MicheleMassa802/computer-controlled-signal-randomized-translingual-neurostimulator/PoNS/PoNS.kicad_pcb

## KiCad design PoNS/PoNS.kicad_pcb (2026-05-09)

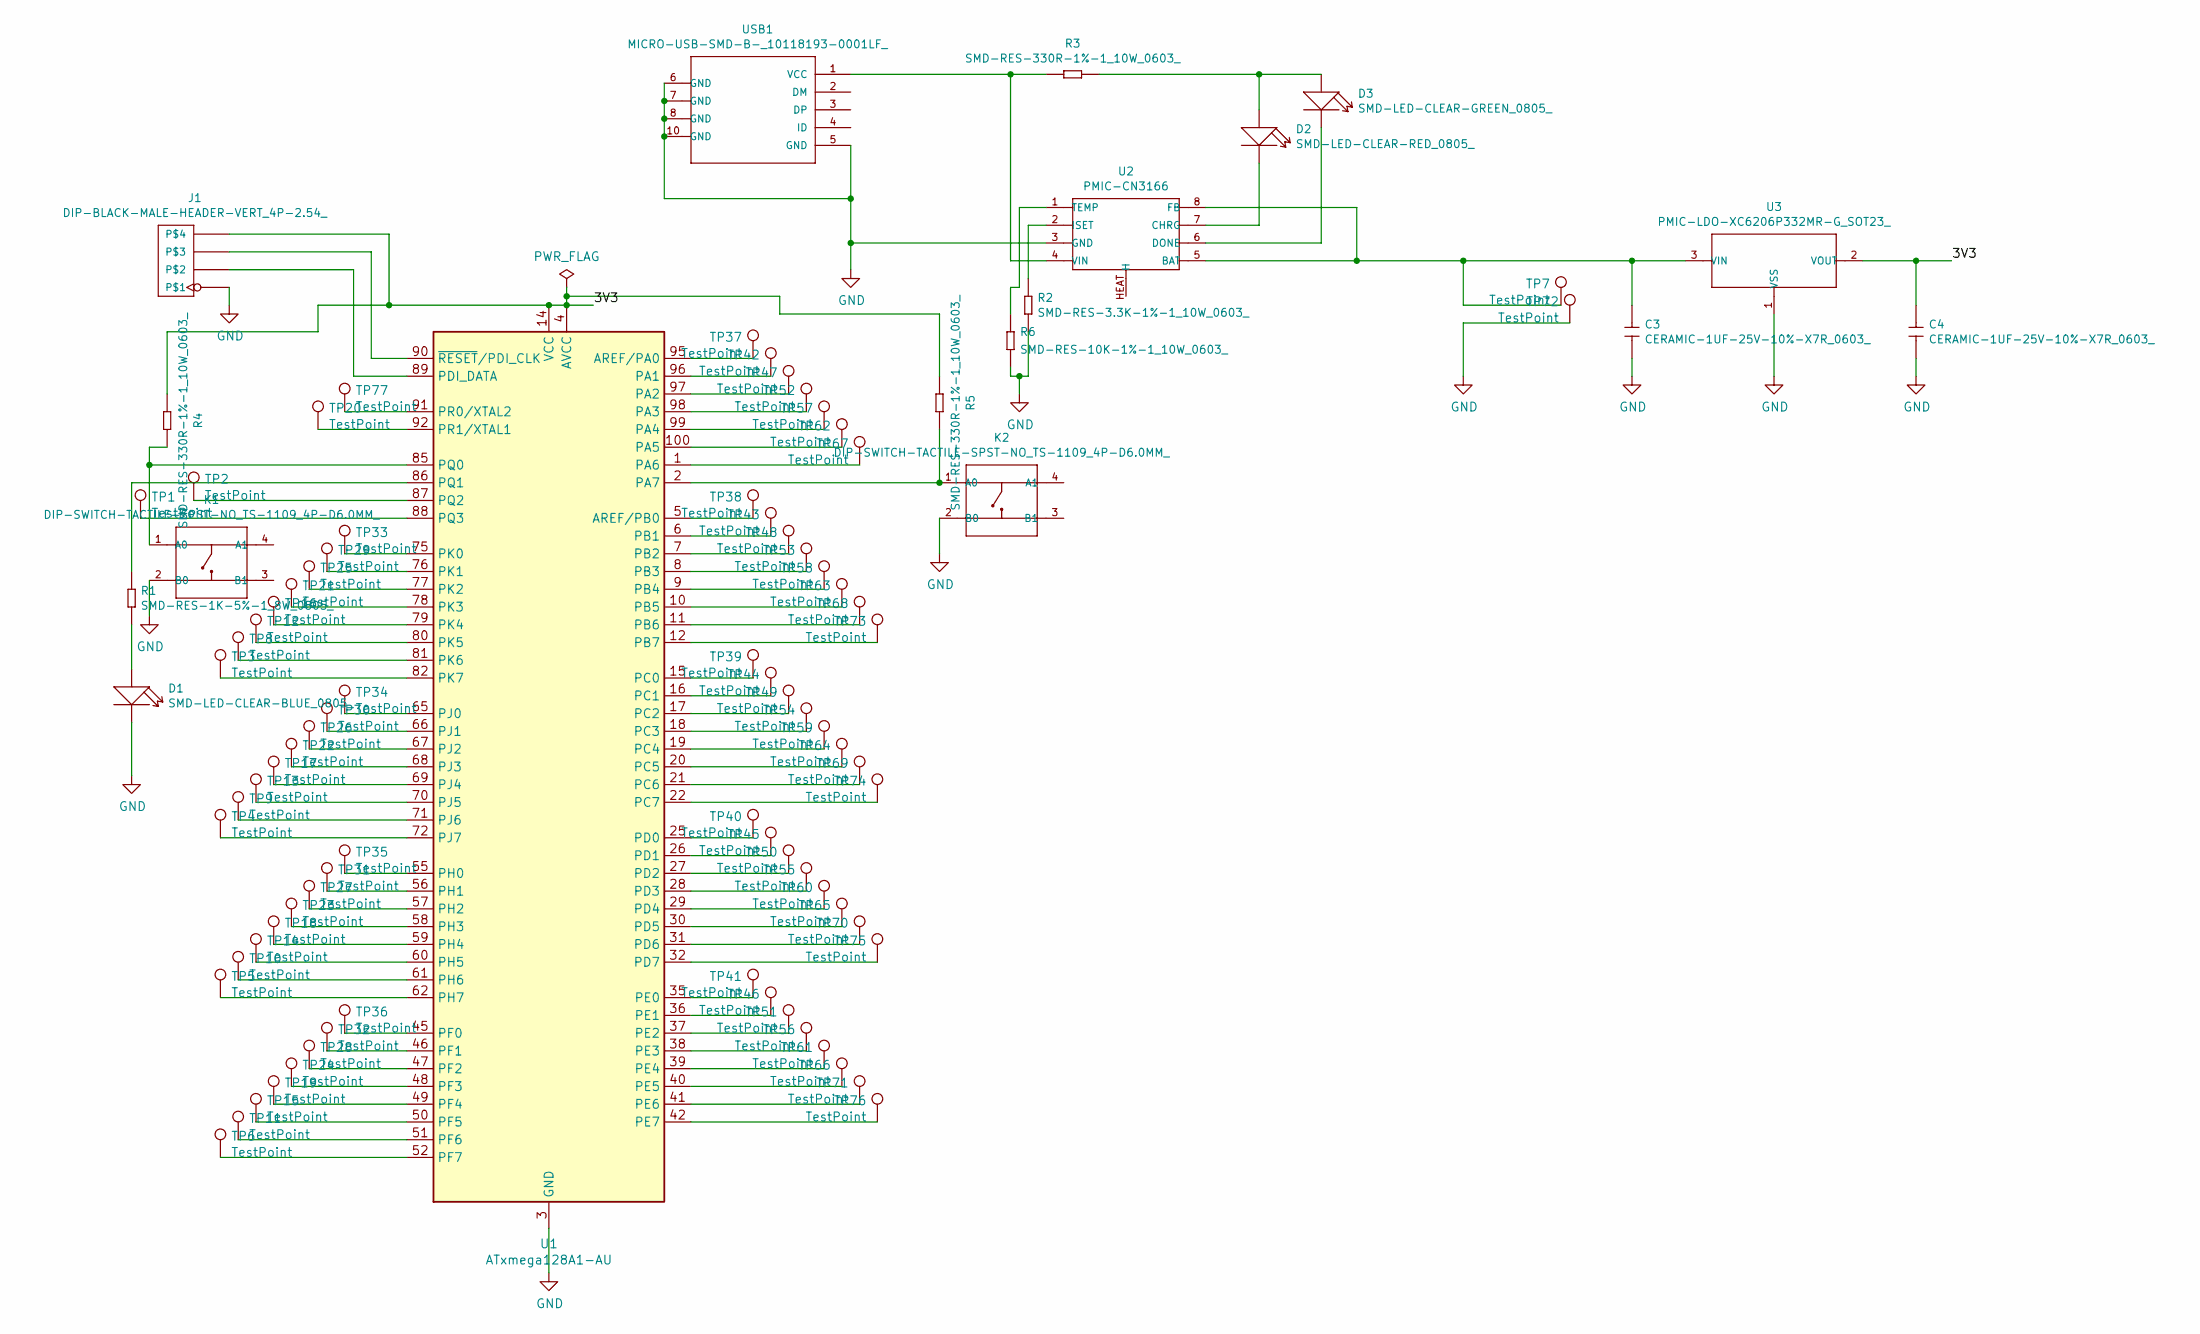
[picture p4: schematic PoNS.kicad_sch]

Parts:
C3, C4: CERAMIC-1UF-25V-10%-X7R_0603_; C0603; MPN CC0603KRX7R8BB105
D1: SMD-LED-CLEAR-BLUE_0805_; LED-0805; MPN EL-17-215_BHC-AN1P2_3T
D2: SMD-LED-CLEAR-RED_0805_; LED-0805; MPN 17-215SURC_S530-A2_TR8
D3: SMD-LED-CLEAR-GREEN_0805_; LED-0805; MPN 17-215SYGC_S530-E2_TR8
J1: DIP-BLACK-MALE-HEADER-VERT_4P-2.54_; H4-2.54; MPN P125-1104A0BS116A1
K1, K2: DIP-SWITCH-TACTILE-SPST-NO_TS-1109_4P-D6.0MM_; SW4-6.0X6.0X5.0MM
R1: SMD-RES-1K-5%-1_8W_0805_; R0805; MPN RC0805JR-071KL
R2: SMD-RES-3.3K-1%-1_10W_0603_; R0603; MPN RC0603FR-073K3L
R3, R4, R5: SMD-RES-330R-1%-1_10W_0603_; R0603; MPN RC0603FR-07330RL
R6: SMD-RES-10K-1%-1_10W_0603_; R0603; MPN RC0603FR-0710KL
TP1, TP2, TP3, TP4, TP5, TP6, TP8, TP9, TP10, TP11, TP12, TP13, TP14, TP15, TP16, TP17, TP18, TP19, TP20, TP21, TP22, TP23, TP24, TP25, TP26, TP27, TP28, TP29, TP30, TP31, TP32, TP33, TP34, TP35, TP36, TP37, TP38, TP39, TP40, TP41, TP42, TP43, TP44, TP45, TP46, TP47, TP48, TP49, TP50, TP51, TP52, TP53, TP54, TP55, TP56, TP57, TP58, TP59, TP60, TP61, TP62, TP63, TP64, TP65, TP66, TP67, TP68, TP69, TP70, TP71, TP73, TP74, TP75, TP76, TP77: TestPoint; TestPoint_Pad_1.0x1.0mm
TP7, TP72: TestPoint; SolderWire-0.75sqmm_1x01_D1.25mm_OD2.3mm
U1: ATxmega128A1-AU; TQFP-100_14x14mm_P0.5mm
U2: PMIC-CN3166; DFN8G-0.5-3X3MM; MPN CN3065
U3: PMIC-LDO-XC6206P332MR-G_SOT23_; SOT-23; MPN XC6206P332MR-G
USB1: MICRO-USB-SMD-B-_10118193-0001LF_; MICRO-USB5+6P-SMD-0.65-B; MPN 10118193-0001LF

Connections:
/3V3: C4.1, J1.4, R4.1, R5.1, U1.4 (AVCC), U1.14 (VCC), U1.24 (VCC), U1.34 (VCC), U1.44 (VCC), U1.54 (VCC), U1.64 (VCC), U1.74 (VCC), U1.83 (VCC), U1.94 (AVCC), U3.2 (VOUT)
GND: C3.2, C4.2, D1.2 (-), J1.1, K1.2 (B0), K2.2 (B0), R2.2, R6.2, TP72.1, U1.3 (GND), U1.13 (GND), U1.23 (GND), U1.33 (GND), U1.43 (GND), U1.53 (GND), U1.63 (GND), U1.73 (GND), U1.84 (GND), U1.93 (GND), U2.3 (GND), U3.1 (VSS), USB1.5 (GND), USB1.6 (GND), USB1.7 (GND), USB1.8 (GND), USB1.9 (GND), USB1.10 (GND), USB1.11 (GND)
unnamed: D1.1 (+), R1.2
unnamed: D2.1 (+), D3.1 (+), R3.2
unnamed: D2.2 (-), U2.7 (CHRG)
unnamed: D3.2 (-), U2.6 (DONE)
unnamed: J1.2, U1.89 (PDI_DATA)
unnamed: J1.3, U1.90 (~RESET/PDI_CLK)
unnamed: K1.1 (A0), R4.2, U1.85 (PQ0)
unnamed: K2.1 (A0), R5.2, U1.2 (PA7)
unnamed: TP37.1, U1.95 (AREF/PA0)
unnamed: TP38.1, U1.5 (AREF/PB0)
unnamed: TP42.1, U1.96 (PA1)
unnamed: TP47.1, U1.97 (PA2)
unnamed: TP52.1, U1.98 (PA3)
unnamed: TP57.1, U1.99 (PA4)
unnamed: TP62.1, U1.100 (PA5)
unnamed: TP67.1, U1.1 (PA6)
unnamed: TP43.1, U1.6 (PB1)
unnamed: TP48.1, U1.7 (PB2)
unnamed: TP53.1, U1.8 (PB3)
unnamed: TP58.1, U1.9 (PB4)
unnamed: TP63.1, U1.10 (PB5)
unnamed: TP68.1, U1.11 (PB6)
unnamed: TP73.1, U1.12 (PB7)
unnamed: TP39.1, U1.15 (PC0)
unnamed: TP44.1, U1.16 (PC1)
unnamed: TP49.1, U1.17 (PC2)
unnamed: TP54.1, U1.18 (PC3)
unnamed: TP59.1, U1.19 (PC4)
unnamed: TP64.1, U1.20 (PC5)
unnamed: TP69.1, U1.21 (PC6)
unnamed: TP74.1, U1.22 (PC7)
unnamed: TP40.1, U1.25 (PD0)
unnamed: TP45.1, U1.26 (PD1)
unnamed: TP50.1, U1.27 (PD2)
unnamed: TP55.1, U1.28 (PD3)
unnamed: TP60.1, U1.29 (PD4)
unnamed: TP65.1, U1.30 (PD5)
unnamed: TP70.1, U1.31 (PD6)
unnamed: TP75.1, U1.32 (PD7)
unnamed: TP41.1, U1.35 (PE0)
unnamed: TP46.1, U1.36 (PE1)
unnamed: TP51.1, U1.37 (PE2)
unnamed: TP56.1, U1.38 (PE3)
unnamed: TP61.1, U1.39 (PE4)
unnamed: TP66.1, U1.40 (PE5)
unnamed: TP71.1, U1.41 (PE6)
unnamed: TP76.1, U1.42 (PE7)
unnamed: TP36.1, U1.45 (PF0)
unnamed: TP32.1, U1.46 (PF1)
unnamed: TP28.1, U1.47 (PF2)
unnamed: TP24.1, U1.48 (PF3)
unnamed: TP19.1, U1.49 (PF4)
unnamed: TP15.1, U1.50 (PF5)
unnamed: TP11.1, U1.51 (PF6)
unnamed: TP6.1, U1.52 (PF7)
unnamed: TP35.1, U1.55 (PH0)
unnamed: TP31.1, U1.56 (PH1)
unnamed: TP27.1, U1.57 (PH2)
unnamed: TP23.1, U1.58 (PH3)
unnamed: TP18.1, U1.59 (PH4)
unnamed: TP14.1, U1.60 (PH5)
unnamed: TP10.1, U1.61 (PH6)
unnamed: TP5.1, U1.62 (PH7)
unnamed: TP34.1, U1.65 (PJ0)
unnamed: TP30.1, U1.66 (PJ1)
unnamed: TP26.1, U1.67 (PJ2)
unnamed: TP22.1, U1.68 (PJ3)
unnamed: TP17.1, U1.69 (PJ4)
unnamed: TP13.1, U1.70 (PJ5)
unnamed: TP9.1, U1.71 (PJ6)
unnamed: TP4.1, U1.72 (PJ7)
unnamed: TP33.1, U1.75 (PK0)
unnamed: TP29.1, U1.76 (PK1)
unnamed: TP25.1, U1.77 (PK2)
unnamed: TP21.1, U1.78 (PK3)
unnamed: TP16.1, U1.79 (PK4)
unnamed: TP12.1, U1.80 (PK5)
unnamed: TP8.1, U1.81 (PK6)
unnamed: TP3.1, U1.82 (PK7)
unnamed: R1.1, U1.86 (PQ1)
unnamed: TP2.1, U1.87 (PQ2)
unnamed: TP1.1, U1.88 (PQ3)
unnamed: TP77.1, U1.91 (PR0/XTAL2)
unnamed: TP20.1, U1.92 (PR1/XTAL1)
unnamed: C3.1, TP7.1, U2.5 (BAT), U2.8 (FB), U3.3 (VIN)
unnamed: R2.1, U2.2 (ISET)
unnamed: R6.1, U2.1 (TEMP)
unnamed: R3.1, U2.4 (VIN), USB1.1 (VCC)

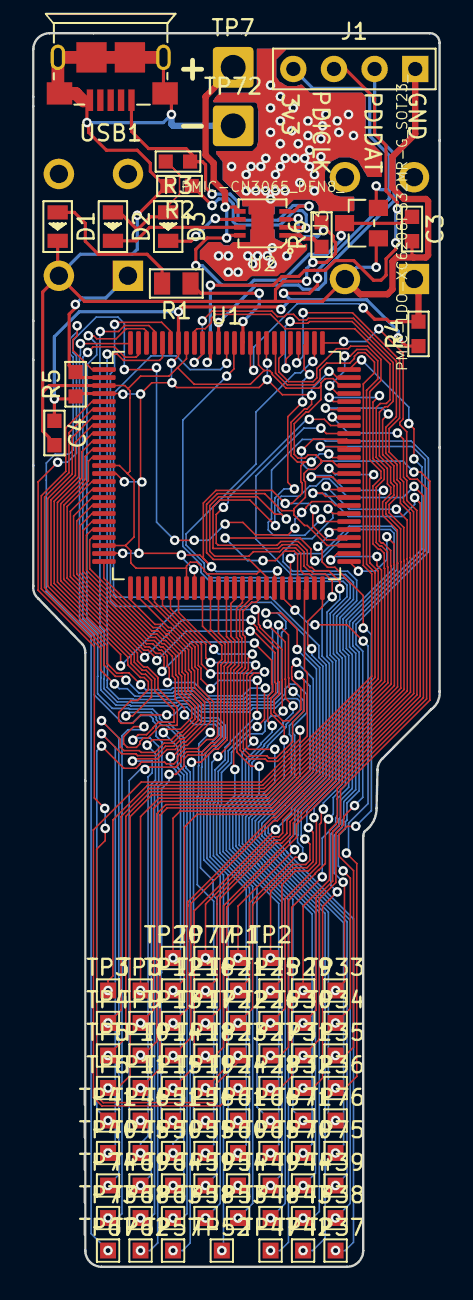
[picture p5: board PoNS.kicad_pcb from above]

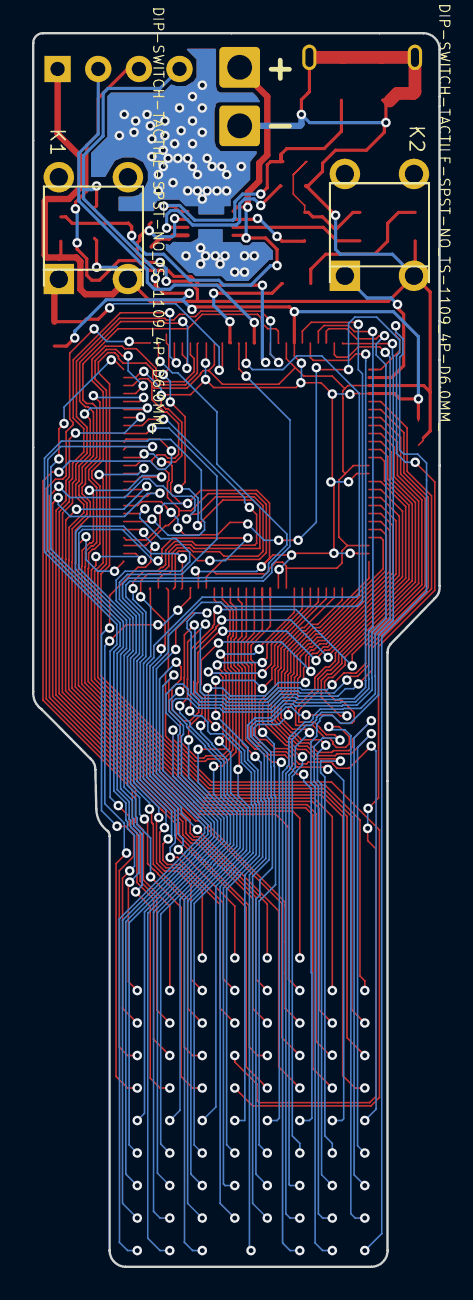
[picture p6: board PoNS.kicad_pcb from below]

Board: 2 copper layers, 25.4 x 77.1 mm, 95 parts (2 on the bottom side), 90 nets.
