MicheleMassa802/computer-controlled-signal-randomized-translingual-neurostimulator/design_log/20260404_203522.jpg

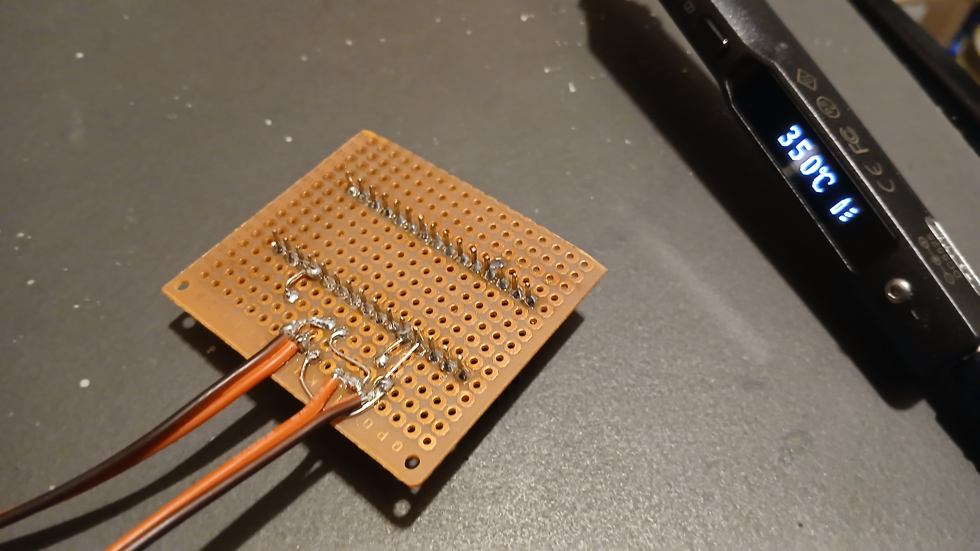
design_log/20260404_203522.jpg
