MicheleMassa802/computer-controlled-signal-randomized-translingual-neurostimulator/design_log/Arduino_bridge_firmware/2026_03_09_arduino_bridge_firmware/2026_03_09_arduino_bridge_firmware.ino

/* 

*/

void setup() {
  Serial.begin(9600); //begin serial communication at 9600 baud
}

void loop() {
  // if we get a valid byte, read analog ins:
  if (Serial.available() > 0) {
    // get incoming byte:
    inByte = Serial.read();
    // read first analog input, divide by 4 to make the range 0-255:
    firstSensor = analogRead(A0) / 4;
    // delay 10ms to let the ADC recover:
    delay(10);
    // read second analog input, divide by 4 to make the range 0-255:
    secondSensor = analogRead(1) / 4;
    // read switch, map it to 0 or 255L
    thirdSensor = map(digitalRead(2), 0, 1, 0, 255);
    // send sensor values:
    Serial.write(firstSensor);
    Serial.write(secondSensor);
    Serial.write(thirdSensor);
  }
}
